weltraumschrott/calling-line-identification-receiver-module/Renderings/arduino-interface_B.png

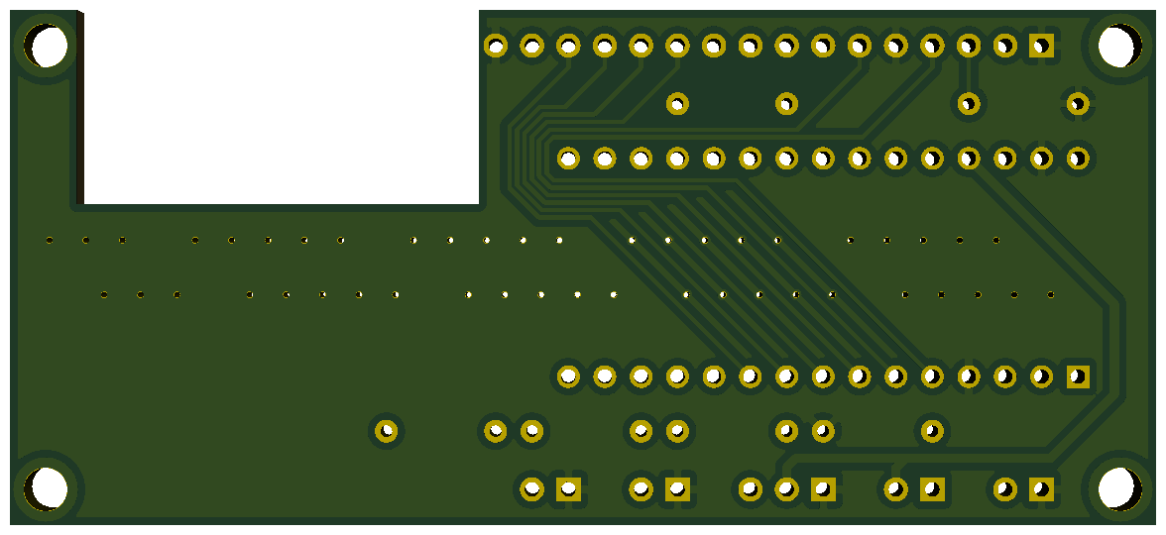
Renderings/arduino-interface_B.png
