weltraumschrott/calling-line-identification-receiver-module/Renderings/arduino-interface_F.png

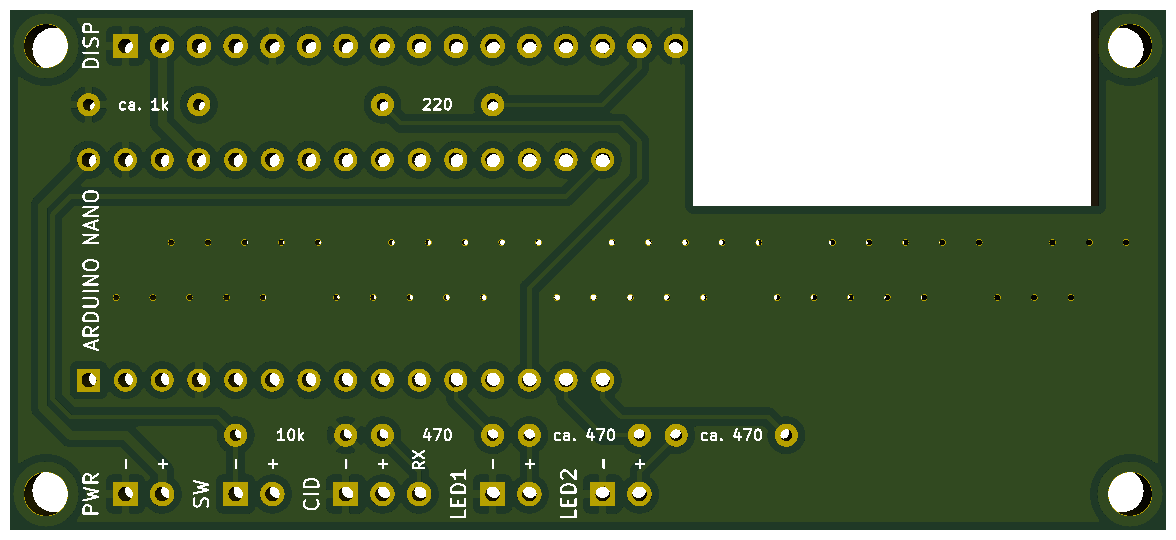
Renderings/arduino-interface_F.png
