weltraumschrott/calling-line-identification-receiver-module/Renderings/calling-line-identification-receiver-module_B.png

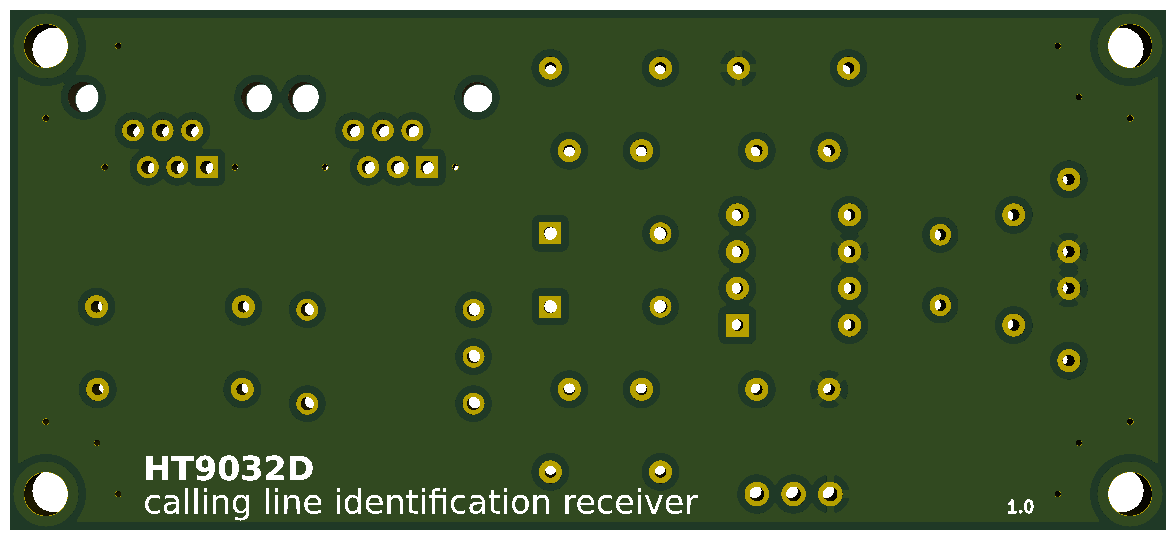
Renderings/calling-line-identification-receiver-module_B.png
