weltraumschrott/calling-line-identification-receiver-module/Renderings/calling-line-identification-receiver-module_F.png

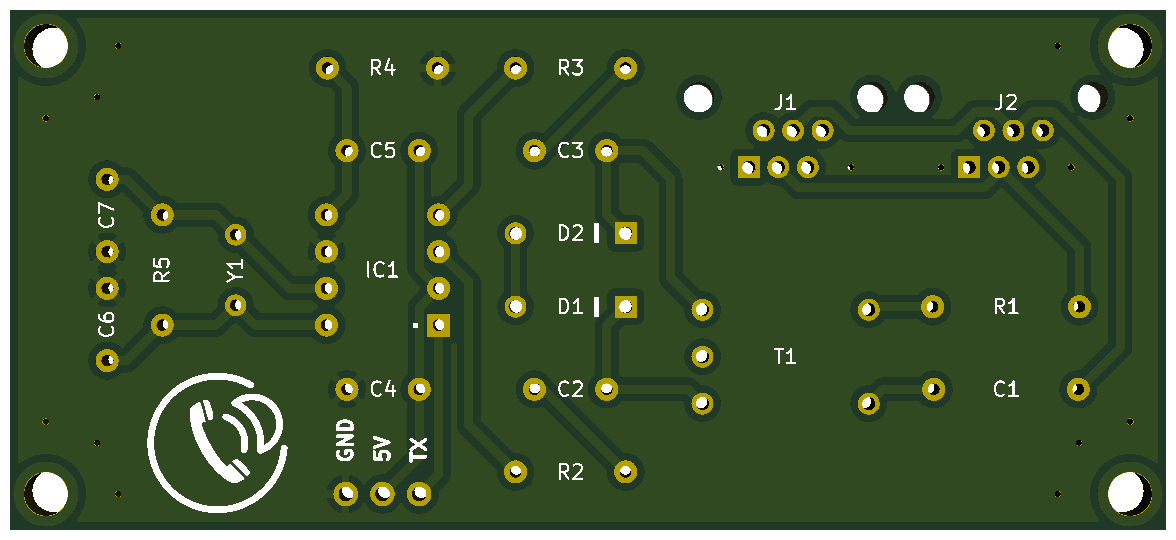
Renderings/calling-line-identification-receiver-module_F.png
