weltraumschrott/calling-line-identification-receiver-module/Resources/600_600-isolation-transformer.jpg

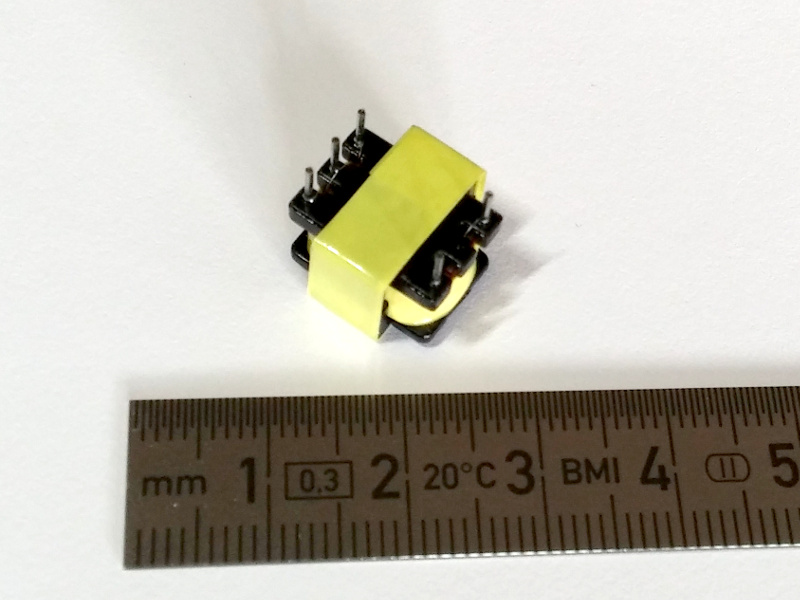
Resources/600_600-isolation-transformer.jpg
