weltraumschrott/calling-line-identification-receiver-module/Resources/600_600-isolation-transformer.png

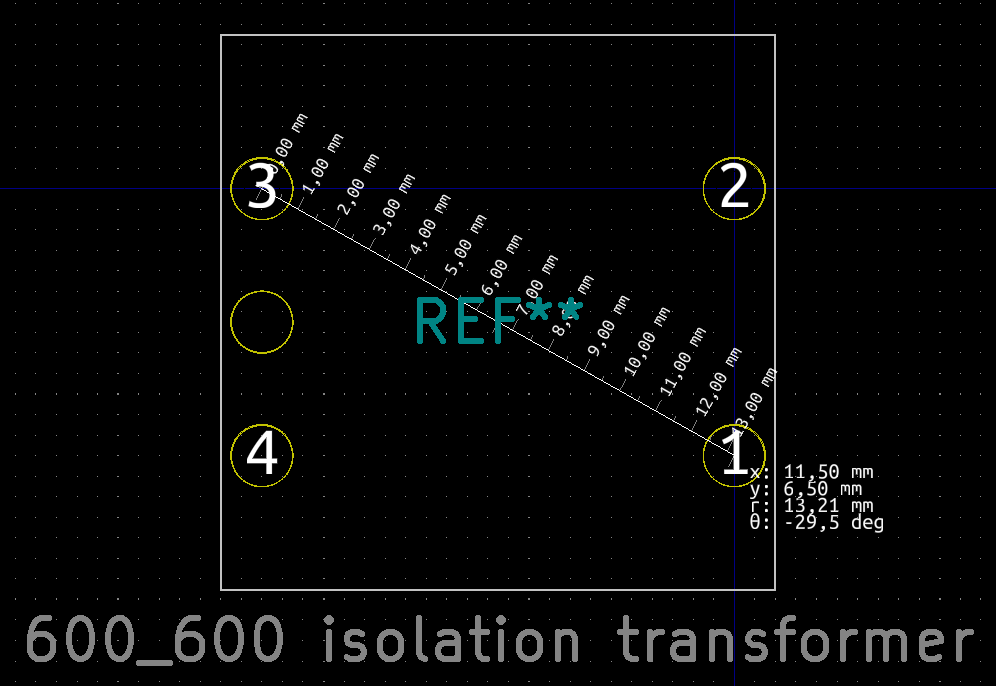
Resources/600_600-isolation-transformer.png
