weltraumschrott/calling-line-identification-receiver-module/Resources/RJ12-6P6C.jpg

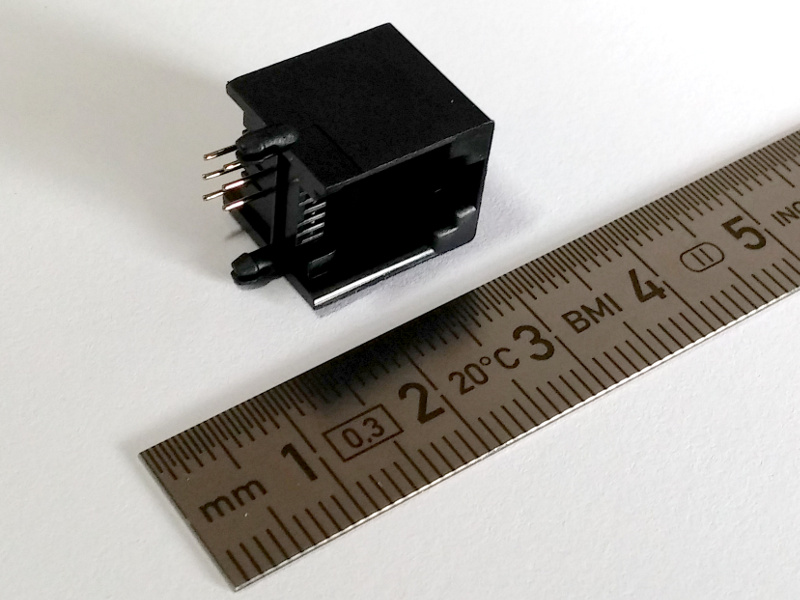
Resources/RJ12-6P6C.jpg
