weltraumschrott/calling-line-identification-receiver-module/Resources/RJ12-6P6C.png

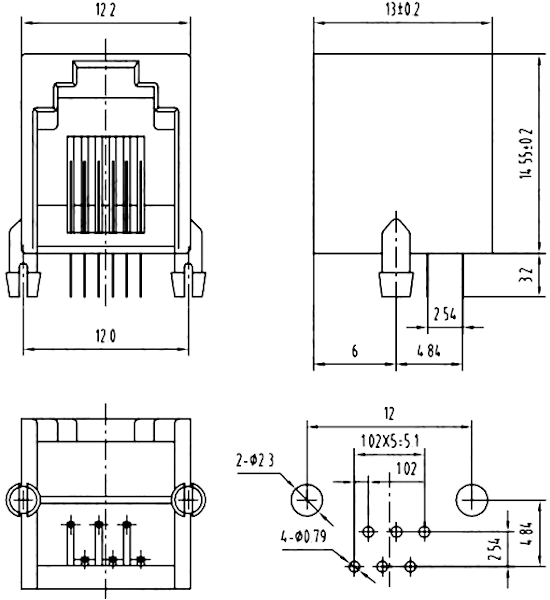
Resources/RJ12-6P6C.png
