weltraumschrott/calling-line-identification-receiver-module/Schematic/arduino-interface.png

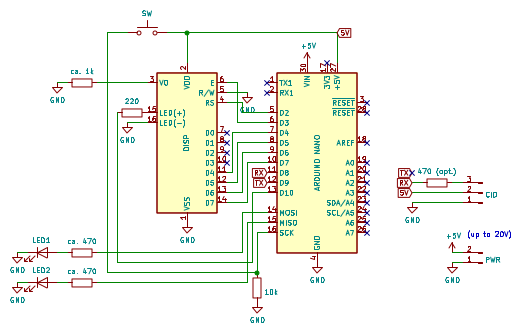
Schematic/arduino-interface.png
