weltraumschrott/calling-line-identification-receiver-module/Schematic/calling-line-identification-receiver-module.png

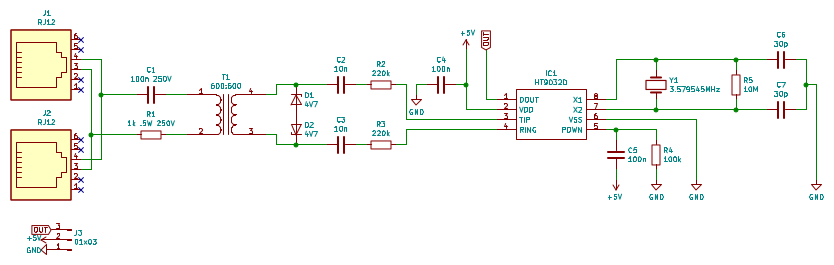
Schematic/calling-line-identification-receiver-module.png
