weltraumschrott/calling-line-identification-receiver-module/Schematic/calling-line-identification-receiver-module.pdf

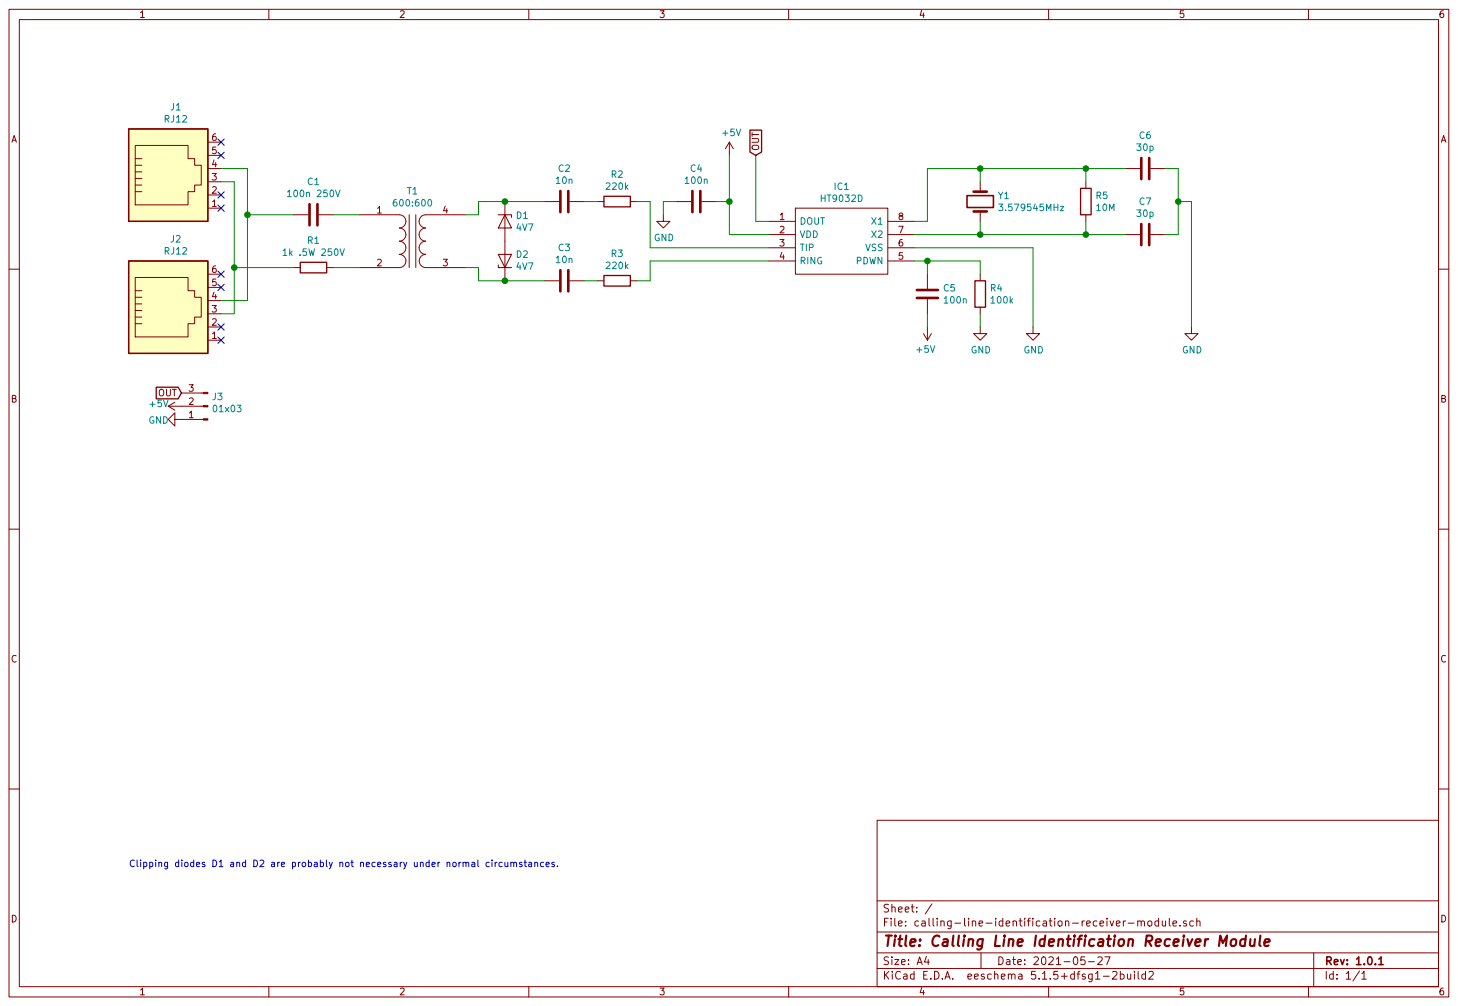
[picture p12: page 1]

OUT Clipping diodes D1 and D2 are probably not necessary under normal circumstances.

File: calling-line-identification-receiver-module.sch Sheet: /
Id: 1/1 Title: Calling Line Identification Receiver Module
