weltraumschrott/calling-line-identification-receiver-module/Schematic/arduino-interface.pdf

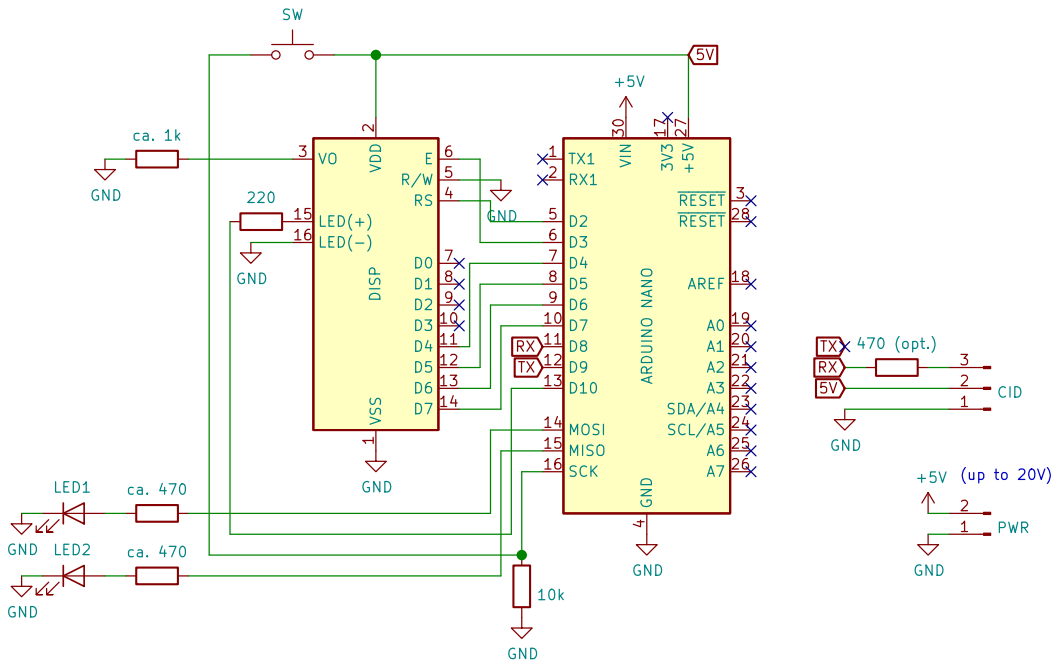
[picture p13: page 1]
